lilburne1/ELEC5550-Team0-03/README.md

This project reflects the hardware and software contributions of Team 0-03 for ELEC5550 in pursuit of a free space optical laser communication system.
