lilburne1/ELEC5550-Team0-03/Hardware Design/Laser_Lens_Standoff/20251012_Laser_Lens_Standoff.3mf

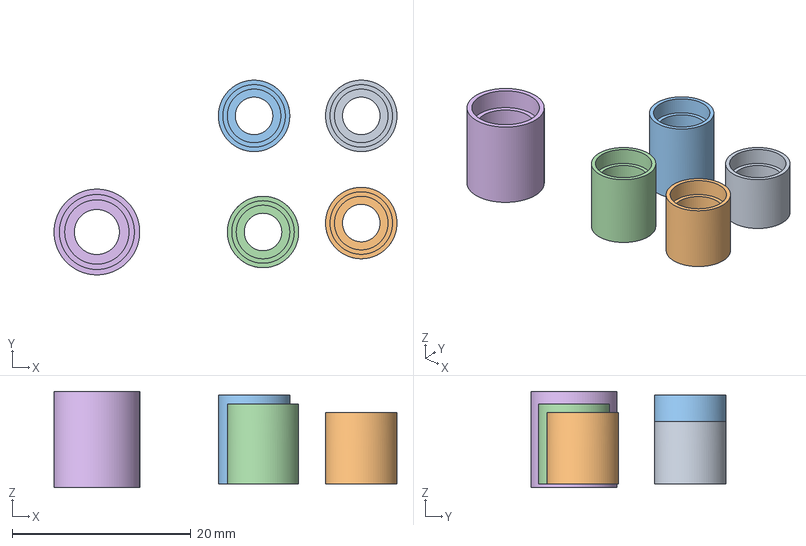
[picture p3: CAD file, 2025-10-23]
Hardware Design/Laser_Lens_Standoff/20251012_Laser_Lens_Standoff.3mf
38.4 x 21.8 x 10.8 mm
