lilburne1/ELEC5550-Team0-03/Hardware Design/Receiver_Design/20250919_Receiver_Design.step

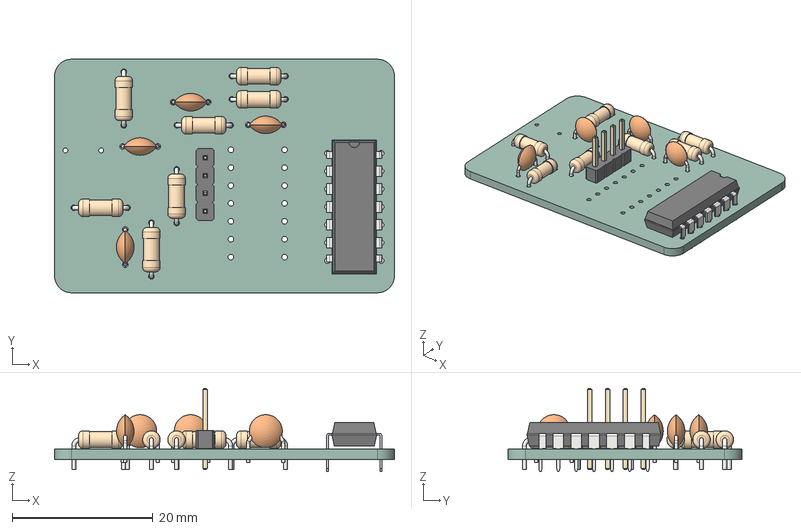
[picture p4: CAD file, 2025-10-23]
Hardware Design/Receiver_Design/20250919_Receiver_Design.step
48.3 x 33.2 x 11.8 mm
DIP-14_W7.62mm
R_Axial_DIN0207_L6.3mm_D2.5mm_P7.62mm_Horizontal x 7
C_Disc_D4.7mm_W2.5mm_P5.00mm x 4
PinHeader_1x04_P2.54mm_Vertical
Laser Circuit Through Hole_PCB
