lilburne1/ELEC5550-Team0-03/Hardware Design/Design_Enclosure/20251017_Design_Enclosure_Top.3mf

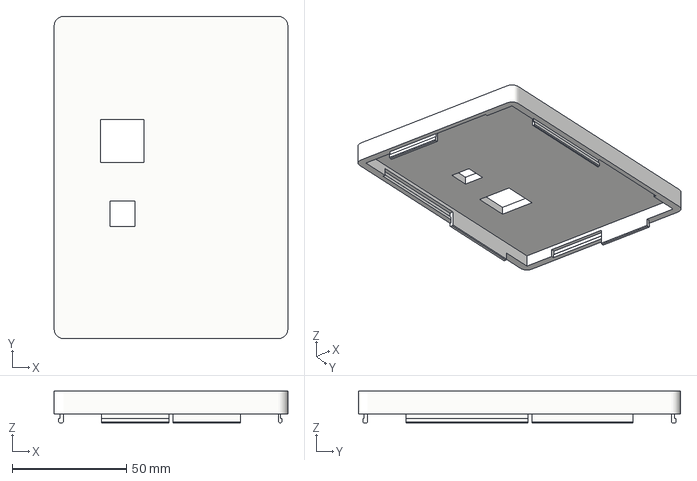
[picture p5: CAD file, 2025-10-23]
Hardware Design/Design_Enclosure/20251017_Design_Enclosure_Top.3mf
102.3 x 141.0 x 14.0 mm
