lilburne1/ELEC5550-Team0-03/(list of files, cad)

Other CAD files:
Hardware Design/Design_Enclosure/20251017_Design_Enclosure.f3z
Hardware Design/Laser_Lens_Standoff/20251012_Laser_Lens_Standoff.f3d
