lilburne1/ELEC5550-Team0-03/Hardware Design/Receiver_Design/20250919_Receiver_Design.kicad_pcb

## KiCad design Hardware Design/Receiver_Design/20250919_Receiver_Design.kicad_pcb (2025-10-23)

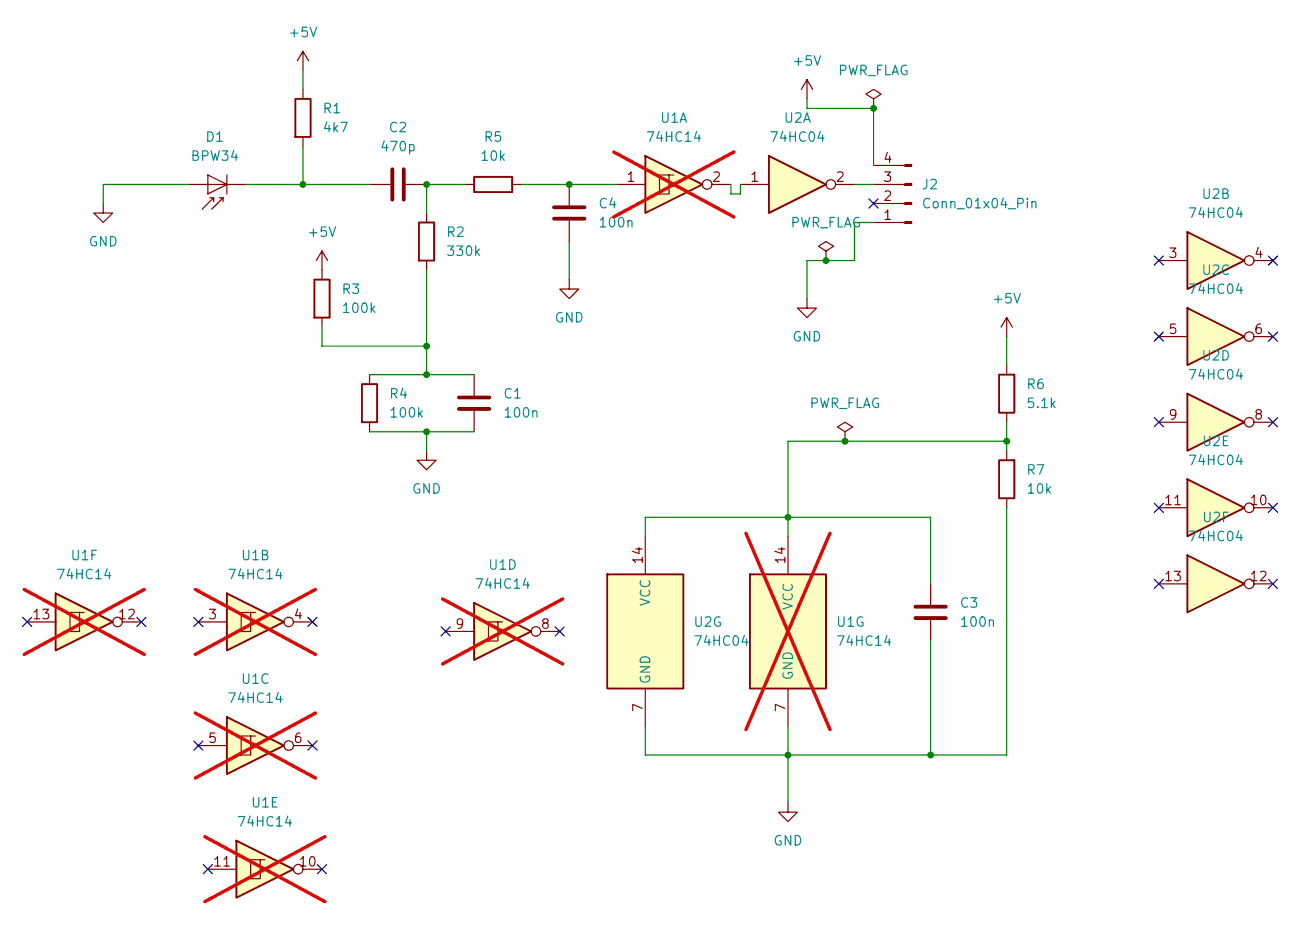
[picture p6: schematic 20250919_Receiver_Design.kicad_sch]

Parts:
C1, C3, C4: 100n; C_Disc_D4.7mm_W2.5mm_P5.00mm; JLC Component Number C14663
C2: 470p; C_Disc_D4.7mm_W2.5mm_P5.00mm; JLC Component Number C1588
D1: BPW34; Osram_DIL2_4.3x4.65mm_P5.08mm; JLC Component Number C85128
J2: Conn_01x04_Pin; PinHeader_1x04_P2.54mm_Vertical
R1: 4k7; R_Axial_DIN0207_L6.3mm_D2.5mm_P7.62mm_Horizontal; JLC Component Number C23162
R2: 330k; R_Axial_DIN0207_L6.3mm_D2.5mm_P7.62mm_Horizontal; JLC Component Number C22935
R3, R4: 100k; R_Axial_DIN0207_L6.3mm_D2.5mm_P7.62mm_Horizontal; JLC Component Number C23178
R5: 10k; R_Axial_DIN0207_L6.3mm_D2.5mm_P7.62mm_Horizontal; JLC Component Number C23162
R6: 5.1k; R_Axial_DIN0207_L6.3mm_D2.5mm_P7.62mm_Horizontal; JLC Component Number C22935
R7: 10k; R_Axial_DIN0207_L6.3mm_D2.5mm_P7.62mm_Horizontal; JLC Component Number C22935
U1: 74HC14; DIP-14_W7.62mm; not fitted
U2: 74HC04; DIP-14_W7.62mm

Connections:
+5V: J2.4, R1.1, R3.1, R6.2
GND: C1.2, C3.1, C4.1, D1.2 (A), J2.1, R4.2, R7.1, U1.7 (GND), U2.7 (GND)
unnamed: C1.1, R2.2, R3.2, R4.1
unnamed: C2.2, R2.1, R5.1
unnamed: C4.2, R5.2, U1.1
unnamed: C2.1, D1.1 (K), R1.2
unnamed: J2.3, U2.2
unnamed: U1.2, U2.1
unnamed: C3.2, R6.1, R7.2, U1.14 (VCC), U2.14 (VCC)

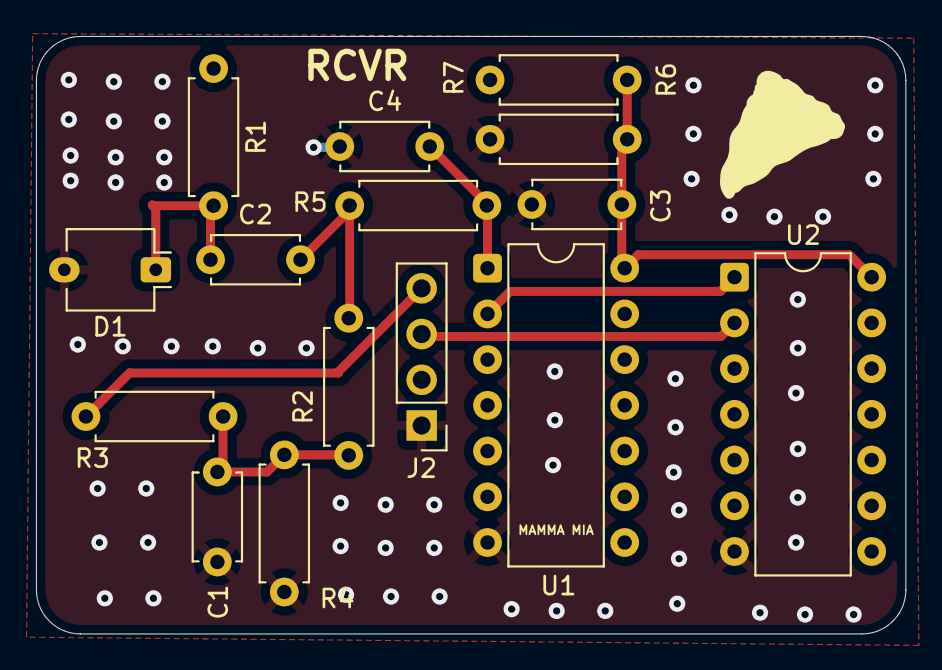
[picture p7: board 20250919_Receiver_Design.kicad_pcb from above]

Board: 2 copper layers, 48.3 x 33.2 mm, 15 parts (0 on the bottom side), 9 nets.
