lilburne1/ELEC5550-Team0-03/Hardware Design/Laser_Design/20250920_Laser_Design.kicad_pcb

## KiCad design Hardware Design/Laser_Design/20250920_Laser_Design.kicad_pcb (2025-10-23)

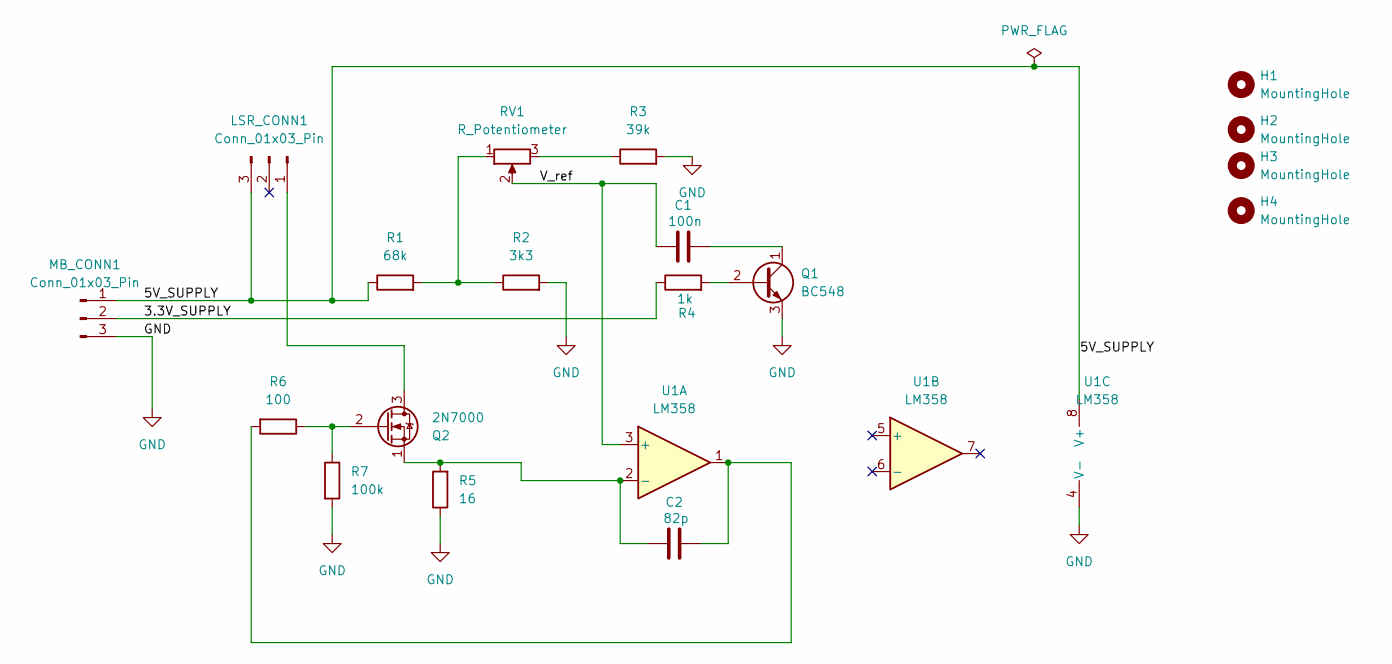
[picture p8: schematic 20250920_Laser_Design.kicad_sch]

Parts:
C1: 100n; C_Disc_D4.7mm_W2.5mm_P5.00mm
C2: 82p; C_Disc_D4.7mm_W2.5mm_P5.00mm
H1, H2, H3, H4: MountingHole; MountingHole_2.2mm_M2
LSR_CONN1: Conn_01x03_Pin; PinHeader_1x03_P2.54mm_Vertical
MB_CONN1: Conn_01x03_Pin; PinHeader_1x03_P2.54mm_Vertical
Q1: BC548; TO-92_Inline
Q2: 2N7000; TO-92_Inline
R1: 68k; R_Axial_DIN0207_L6.3mm_D2.5mm_P7.62mm_Horizontal
R2: 3k3; R_Axial_DIN0207_L6.3mm_D2.5mm_P7.62mm_Horizontal
R3: 39k; R_Axial_DIN0207_L6.3mm_D2.5mm_P7.62mm_Horizontal
R4: 1k; R_Axial_DIN0207_L6.3mm_D2.5mm_P7.62mm_Horizontal
R5: 16; R_Axial_DIN0207_L6.3mm_D2.5mm_P7.62mm_Horizontal
R6: 100; R_Axial_DIN0207_L6.3mm_D2.5mm_P7.62mm_Horizontal
R7: 100k; R_Axial_DIN0207_L6.3mm_D2.5mm_P7.62mm_Horizontal
RV1: R_Potentiometer; Potentiometer_Bourns_3296W_Vertical
U1: LM358; DIP-8_W7.62mm

Connections:
/3.3V_SUPPLY: MB_CONN1.2, R4.1
/5V_SUPPLY: LSR_CONN1.3, MB_CONN1.1, R1.1, U1.8 (V+); also elsewhere on the board
/V_ref: C1.1, RV1.2, U1.3 (+)
GND: MB_CONN1.3, Q1.3 (E), R2.2, R3.2, R5.1, R7.2, U1.4 (V-)
unnamed: C2.2, R6.2, U1.1
unnamed 5: LSR_CONN1.1, Q2.3 (D); also elsewhere on the board
unnamed: Q1.2 (B), R4.2
unnamed: C1.2, Q1.1 (C)
unnamed: Q2.2 (G), R6.1, R7.1
unnamed: C2.1, Q2.1 (S), R5.2, U1.2 (-)
unnamed: R1.2, R2.1, RV1.1
unnamed: R3.1, RV1.3

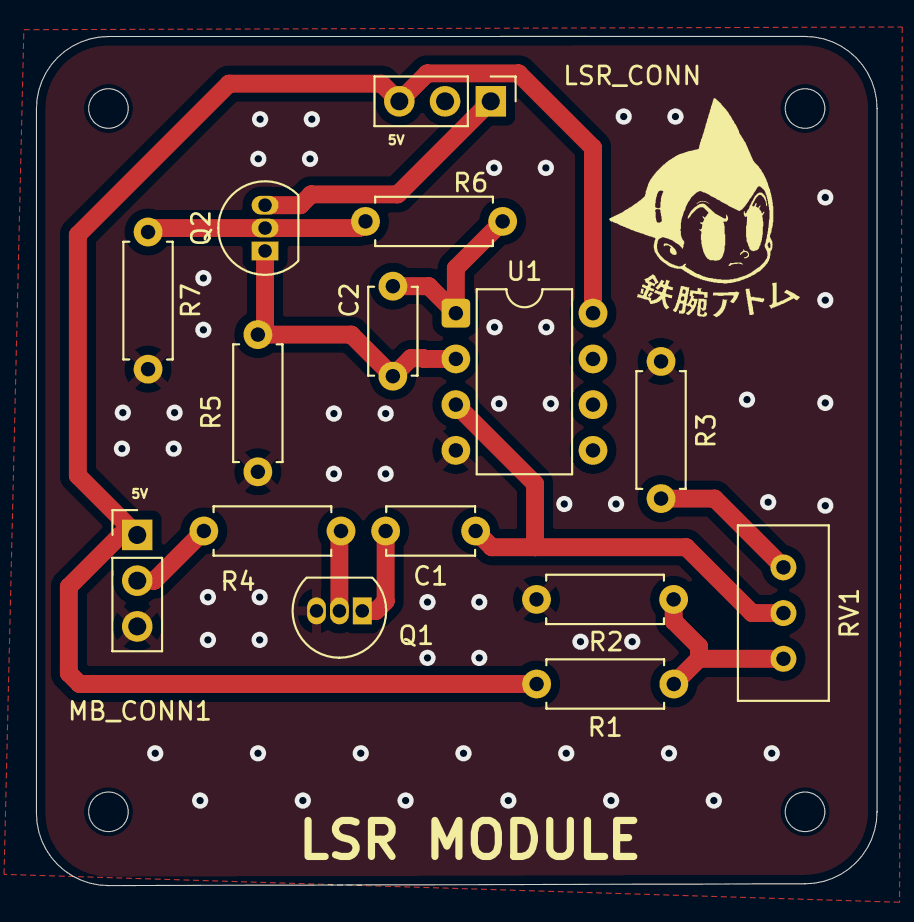
[picture p9: board 20250920_Laser_Design.kicad_pcb from above]

Board: 2 copper layers, 46.7 x 47.2 mm, 19 parts (0 on the bottom side), 12 nets.

Other parts of the board:
LSR_CONN: Conn_01x03_Pin; PinHeader_1x03_P2.54mm_Vertical

Their connections:
/5V_SUPPLY: LSR_CONN.3; also elsewhere on the board
unnamed 5: LSR_CONN.1; also elsewhere on the board
