lilburne1/ELEC5550-Team0-03/Hardware Design/Mainboard_Design/20250915_Mainboard_Design/20250915_Mainboard_Design.kicad_sch

## KiCad design Hardware Design/Mainboard_Design/20250915_Mainboard_Design/20250915_Mainboard_Design.kicad_sch (2025-10-23)

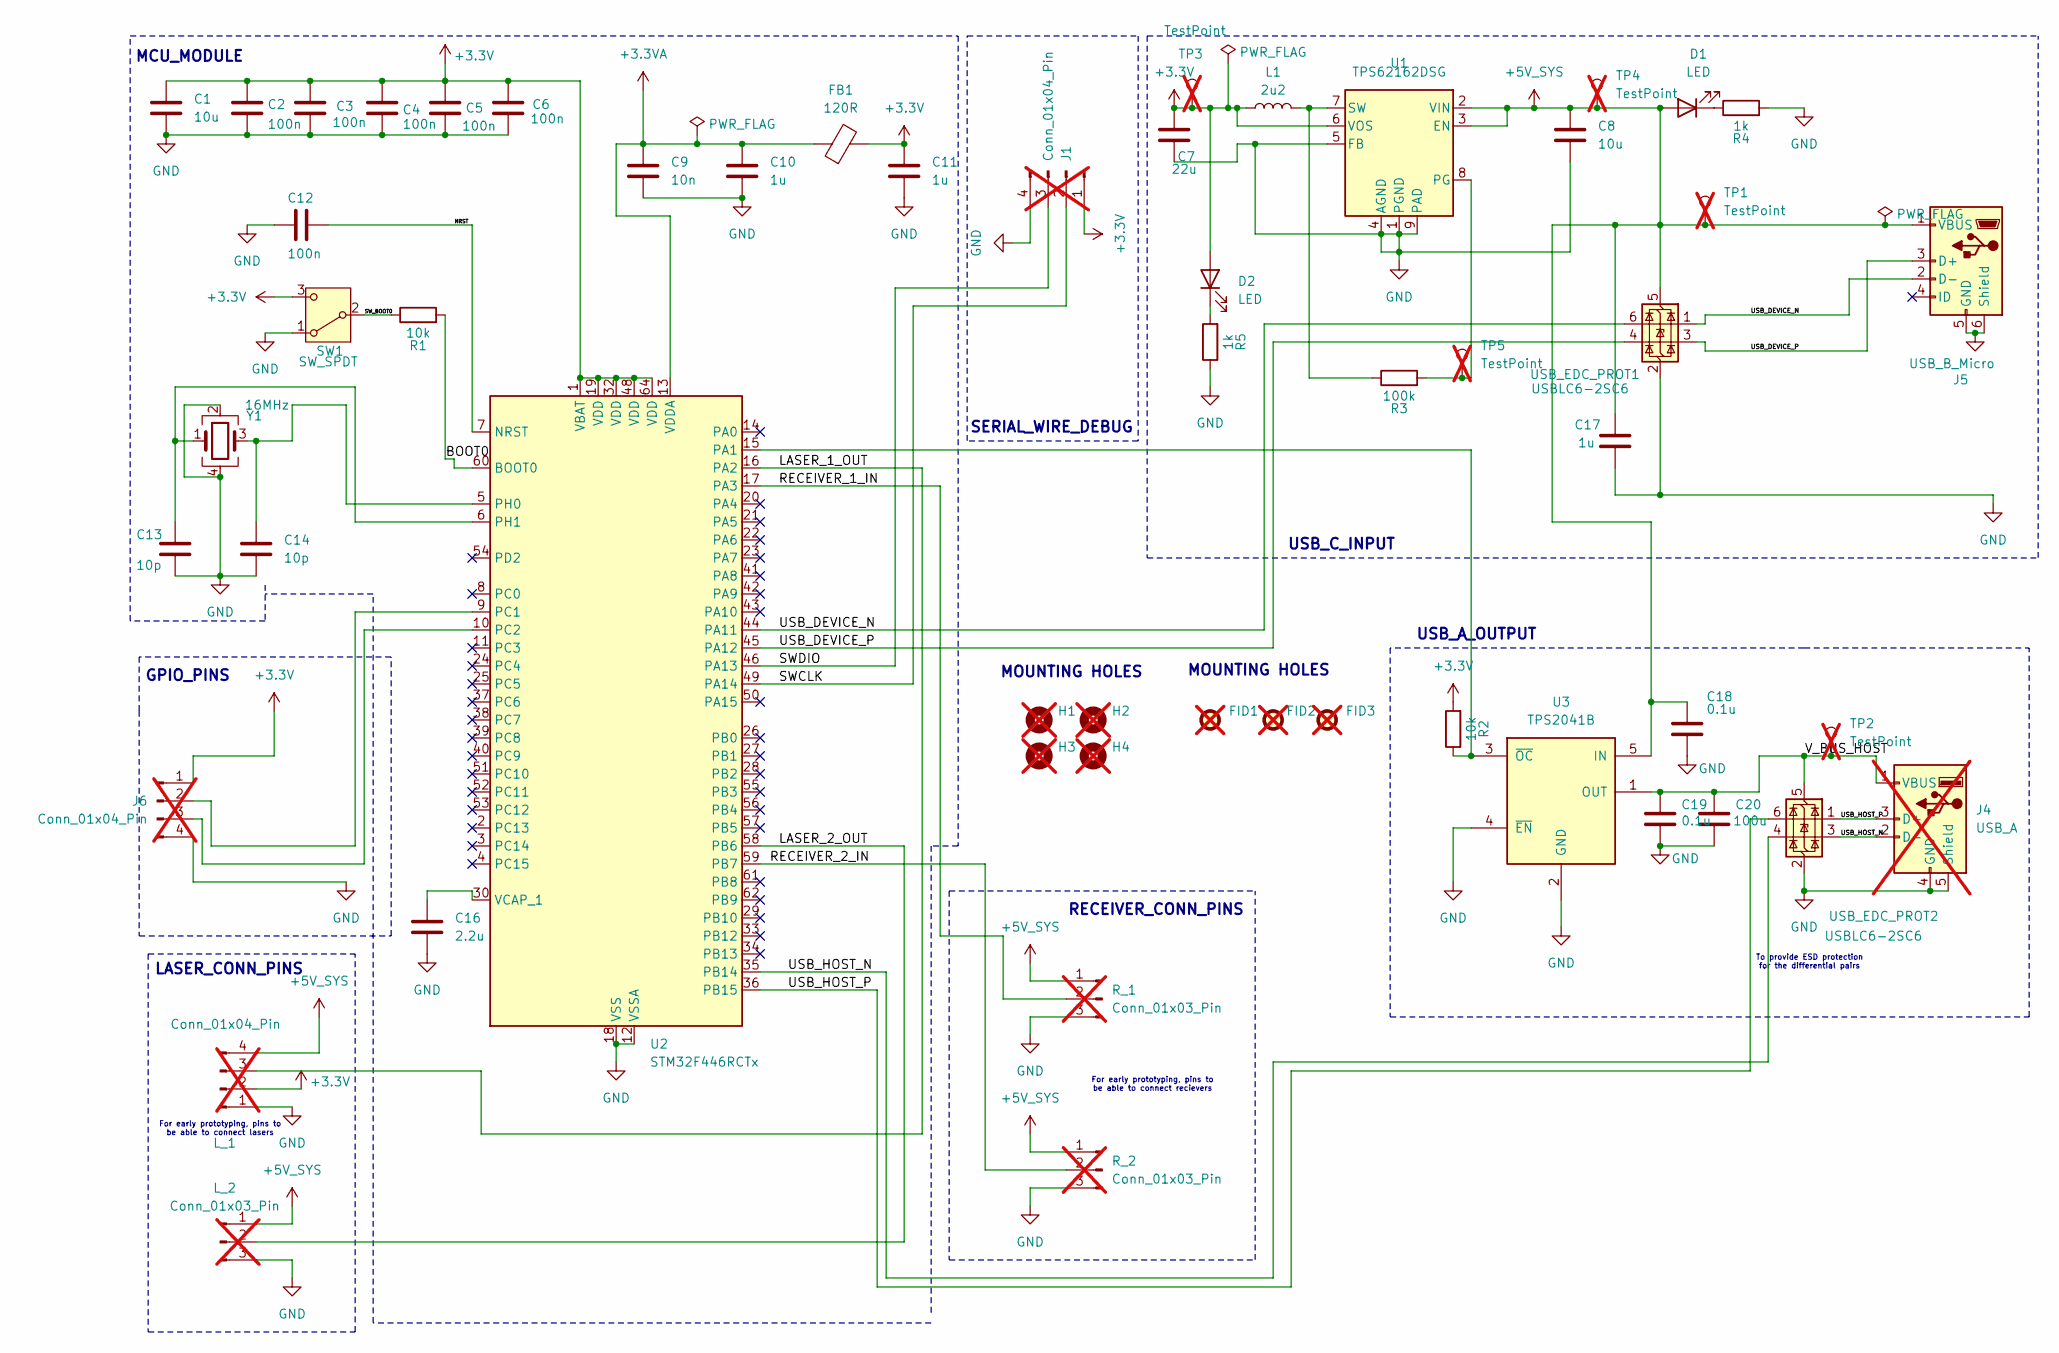
[picture p10: schematic 20250915_Mainboard_Design.kicad_sch]

Parts:
C1, C8: 10u; C_0805_2012Metric; Manufacturer Part Number CL21A106KAYNNNE; JLCPCB Part # C15850
C2, C3, C4, C5, C6, C12: 100n; C_0402_1005Metric; Manufacturer Part Number CL05B104KO5NNNC; JLCPCB Part # C1525
C7: 22u; C_0805_2012Metric; Manufacturer Part Number CL21A226MAQNNNE; JLCPCB Part # C45783
C9: 10n; C_0402_1005Metric; Manufacturer Part Number CL05B103KB5NNNC; JLCPCB Part # C15195
C10, C11, C17: 1u; C_0402_1005Metric; Manufacturer Part Number CL05A105KA5NQNC; JLCPCB Part # C52923
C13, C14: 10p; C_0402_1005Metric; Manufacturer Part Number CL05C100JB5NNNC; JLCPCB Part # C32949
C16: 2.2u; C_0402_1005Metric; Manufacturer Part Number CL05A225MQ5NSNC; JLCPCB Part # C12530
C18, C19: 0.1u; C_0402_1005Metric; Manufacturer Part Number CL05B104KB54PNC; JLCPCB Part # C307331
C20: 100u; C_1206_3216Metric; Manufacturer Part Number CL31A107MQHNNNE; JLCPCB Part # C15008
D1, D2: LED; LED_0603_1608Metric; Manufacturer Part Number KT-0603R; JLCPCB Part # C2286
FB1: 120R; L_0603_1608Metric; Manufacturer Part Number PZ1608D121-1R0TF; JLCPCB Part # C98285
FID1, FID2, FID3: FM; Fiducial_1mm_Mask2mm; not fitted
H1, H2, H3, H4: MountingHole; MountingHole_2.2mm_M2; not fitted
J1, J6: Conn_01x04_Pin; PinHeader_1x04_P2.54mm_Vertical; not fitted
J4: USB_A; USB_A_Wuerth_614004134726_Horizontal; not fitted
J5: USB_B_Micro; USB_Mini-B_Lumberg_2486_01_Horizontal; Manufacturer Part Number 65100516121; JLCPCB Part # C5120592
L1: 2u2; L_TechFuse_SL0420; Manufacturer Part Number SL0420-2R2M; JLCPCB Part # C22463806
L_1: Conn_01x04_Pin; PinHeader_1x04_P2.54mm_Vertical; not fitted
L_2: Conn_01x03_Pin; PinSocket_1x03_P2.54mm_Vertical; not fitted
R1, R2: 10k; R_0402_1005Metric; Manufacturer Part Number 0402WGF1002TCE; JLCPCB Part # C25744
R3: 100k; R_0402_1005Metric; Manufacturer Part Number 0402WGF1001TCE; JLCPCB Part # C11702
R4, R5: 1k; R_0402_1005Metric; Manufacturer Part Number 0402WGF1001TCE; JLCPCB Part # C11702
R_1, R_2: Conn_01x03_Pin; PinSocket_1x03_P2.54mm_Vertical; not fitted
SW1: SW_SPDT; SW_SPDT_PCM12; Manufacturer Part Number PCM12SMTR; JLCPCB Part # C221841
TP1, TP2, TP3, TP4, TP5: TestPoint; TestPoint_Pad_D1.0mm; not fitted
U1: TPS62162DSG; WSON-8-1EP_2x2mm_P0.5mm_EP0.9x1.6mm_ThermalVias; Manufacturer Part Number TPS62162DSGR; JLCPCB Part # C40256
U2: STM32F446RCTx; LQFP-64_10x10mm_P0.5mm; Manufacturer Part Number STM32F446RET6; JLCPCB Part # C69336
U3: TPS2041B; SOT-23-5; Manufacturer Part Number TPS2041BDBVR; JLCPCB Part # C51386
USB_EDC_PROT1, USB_EDC_PROT2: USBLC6-2SC6; SOT-23-6; Manufacturer Part Number USBLC6-2SC6; JLCPCB Part # C7519
Y1: 16MHz; Crystal_SMD_3225-4Pin_3.2x2.5mm; Manufacturer Part Number NX3225SA-16MHz-STD-CSR-6; JLCPCB Part # C880097

Connections:
+3.3V: C1.1, C2.1, C3.1, C4.1, C5.1, C6.1, C7.1, C11.1, D2.2 (A), FB1.2, J1.1, J6.1, L1.2, L_1.2, R2.2, SW1.3 (C), TP3.1, U1.6 (VOS), U2.1 (VBAT), U2.19 (VDD), U2.32 (VDD), U2.48 (VDD), U2.64 (VDD)
+3.3VA: C9.1, C10.1, FB1.1, U2.13 (VDDA)
+5V_SYS: C8.1, C17.2, C18.2, D1.2 (A), J5.1 (VBUS), L_1.4, L_2.1, R_1.1, R_2.1, TP1.1, TP4.1, U1.2 (VIN), U1.3 (EN), U3.5 (IN), USB_EDC_PROT1.5 (VBUS)
BOOT0: R1.2, U2.60 (BOOT0)
GND: C1.2, C2.2, C3.2, C4.2, C5.2, C6.2, C7.2, C8.2, C9.2, C10.2, C11.2, C12.2, C13.2, C14.2, C16.2, C17.1, C18.1, C19.1, C20.1, J1.4, J4.4 (GND), J4.5 (Shield), J5.5 (GND), J5.6 (Shield), J6.4, L_1.1, L_2.3, R4.2, R5.1, R_1.3, R_2.3, SW1.1 (A), U1.1 (PGND), U1.4 (AGND), U1.5 (FB), U1.9 (PAD), U2.12 (VSSA), U2.18 (VSS), U2.31 (VSS), U2.47 (VSS), U2.63 (VSS), U3.2 (GND), U3.4 (~EN), USB_EDC_PROT1.2 (GND), USB_EDC_PROT2.2 (GND), Y1.2, Y1.4
LASER_1_OUT: L_1.3, U2.16 (PA2)
LASER_2_OUT: L_2.2, U2.58 (PB6)
NRST: C12.1, U2.7 (NRST)
unnamed: C13.1, U2.6 (PH1), Y1.1
unnamed: C14.1, U2.5 (PH0), Y1.3
unnamed: C16.1, U2.30 (VCAP_1)
unnamed: D1.1 (K), R4.1
unnamed: D2.1 (K), R5.2
unnamed: J6.2, U2.9 (PC1)
unnamed: J6.3, U2.10 (PC2)
unnamed: L1.1, R3.1, U1.7 (SW)
unnamed: R2.1, U2.15 (PA1), U3.3 (~OC)
unnamed: R3.2, TP5.1, U1.8 (PG)
RECEIVER_1_IN: R_1.2, U2.17 (PA3)
RECEIVER_2_IN: R_2.2, U2.59 (PB7)
SWCLK: J1.2, U2.49 (PA14)
SWDIO: J1.3, U2.46 (PA13)
SW_BOOT0: R1.1, SW1.2 (B)
USB_DEVICE_N: J5.2 (D-), U2.44 (PA11), USB_EDC_PROT1.1 (I/O1), USB_EDC_PROT1.6 (I/O1)
USB_DEVICE_P: J5.3 (D+), U2.45 (PA12), USB_EDC_PROT1.3 (I/O2), USB_EDC_PROT1.4 (I/O2)
USB_HOST_N: J4.2 (D-), U2.35 (PB14), USB_EDC_PROT2.3 (I/O2), USB_EDC_PROT2.4 (I/O2)
USB_HOST_P: J4.3 (D+), U2.36 (PB15), USB_EDC_PROT2.1 (I/O1), USB_EDC_PROT2.6 (I/O1)
V_BUS_HOST: C19.2, C20.2, J4.1 (VBUS), TP2.1, U3.1 (OUT), USB_EDC_PROT2.5 (VBUS)

Notes on the sheet:
GPIO_PINS
To provide ESD protection for the differential pairs
MCU_MODULE
USB_A_OUTPUT
USB_C_INPUT
For early prototyping, pins to be able to connect lasers
For early prototyping, pins to be able to connect recievers
RECEIVER_CONN_PINS
MOUNTING HOLES
LASER_CONN_PINS
SERIAL_WIRE_DEBUG
