lilburne1/ELEC5550-Team0-03/Software Design/SenderDesign/Core/Src/main.c

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
/* Includes ------------------------------------------------------------------*/
#include "main.h"

UART_HandleTypeDef huart1;
UART_HandleTypeDef huart2;
DMA_HandleTypeDef hdma_usart2_rx;
DMA_HandleTypeDef hdma_usart2_tx;

HCD_HandleTypeDef hhcd_USB_OTG_HS;

/* USER CODE BEGIN PV */
queue_t incoming_queue = {};
queue_t outgoing_queue = {};
volatile bool tx_pending = false;
volatile bool hid_device = false;
volatile bool msc_device = false;
/* USER CODE END PV */

void SystemClock_Config(void);
static void MX_GPIO_Init(void);
static void MX_DMA_Init(void);
static void MX_USART2_UART_Init(void);
static void MX_USB_OTG_HS_HCD_Init(void);
static void MX_USART1_UART_Init(void);
/* USER CODE BEGIN 0 */
uint32_t tusb_time_millis_api(void) {
	return HAL_GetTick();
}

int _write(int fd, const void *buf, size_t len) {
  (void)fd;
  HAL_UART_Transmit(&huart1, (uint8_t*)buf, len, HAL_MAX_DELAY); // or huart3 if that’s your VCP
  return (int)len;
}
/* USER CODE END 0 */

/**
  * @brief  The application entry point.
  * @retval int
  */
int main(void)
{

  /* MCU Configuration--------------------------------------------------------*/

  /* Reset of all peripherals, Initializes the Flash interface and the Systick. */
  HAL_Init();

  /* Configure the system clock */
  SystemClock_Config();

  /* Initialize all configured peripherals */
  MX_GPIO_Init();
  MX_DMA_Init();
  MX_USART2_UART_Init();
  MX_USB_OTG_HS_HCD_Init();
  MX_USART1_UART_Init();
  /* USER CODE BEGIN 2 */
  tusb_init();
  uart_rx_init();
  /* USER CODE END 2 */

  /* Infinite loop */
  /* USER CODE BEGIN WHILE */
  while (1)
  {
	  tuh_task();
	  uart_rx_service_sender();
	  uart_tx_service_sender();
    /* USER CODE END WHILE */

    /* USER CODE BEGIN 3 */
  }
  /* USER CODE END 3 */
}

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
