lilburne1/ELEC5550-Team0-03/Software Design/SenderDesign/SenderDesign.ioc

Mcu.UserName=STM32F446RETx
PA10.Signal=USART1_RX
PA2.Signal=USART2_TX
PA3.Signal=USART2_RX
PA9.Signal=USART1_TX
PB14.Signal=USB_OTG_HS_DM
PB15.Signal=USB_OTG_HS_DP
PH0-OSC_IN.Signal=RCC_OSC_IN
PH1-OSC_OUT.Signal=RCC_OSC_OUT
