lilburne1/ELEC5550-Team0-03/Software Design/SenderDesign/Core/Inc/tusb_config.h

/*
 * The MIT License (MIT)
 *
 * Copyright (c) 2019 Ha Thach (tinyusb.org)
 *
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
 */

#ifndef _TUSB_CONFIG_H_
#define _TUSB_CONFIG_H_

#ifdef __cplusplus
extern "C" {
#endif

// MCU / OS
#define CFG_TUSB_MCU          OPT_MCU_STM32F4
#define CFG_TUSB_OS           OPT_OS_NONE
#define CFG_TUSB_DEBUG        2

// -------- RHPort mode: HOST on FS --------
//#define CFG_TUSB_RHPORT0_MODE   (OPT_MODE_HOST | OPT_MODE_FULL_SPEED)
#define CFG_TUSB_RHPORT1_MODE   (OPT_MODE_HOST | OPT_MODE_FULL_SPEED)

#define CFG_TUH_ENUMERATION_BUFSIZE 512

// -------- Enable stacks --------
#define CFG_TUH_ENABLED         1       // Host stack ON
#define CFG_TUD_ENABLED         0       // Device stack OFF (explicit)

// -------- Host class config --------
#define CFG_TUH_HID             1
#define CFG_TUH_MSC             1
#define CFG_TUH_MSC_MAXLUN      4
#define CFG_TUH_HUB             0
#define CFG_TUH_HID_EPIN_BUFSIZE   64
#define CFG_TUH_HID_EPOUT_BUFSIZE  64

#ifndef CFG_TUSB_MEM_SECTION
#define CFG_TUSB_MEM_SECTION
#endif
#ifndef CFG_TUSB_MEM_ALIGN
#define CFG_TUSB_MEM_ALIGN      __attribute__ ((aligned(4)))
#endif

#ifdef __cplusplus
}
#endif
#endif // _TUSB_CONFIG_H_
