lilburne1/ELEC5550-Team0-03/(notices)

Notices in the files:
Software Design/SenderDesign/Core/Src/main.c:
Copyright (c) 2025 STMicroelectronics.
All rights reserved.
This software is licensed under terms that can be found in the LICENSE file
